SeeedDocument/Ethernet_Shield_V1.0/img/Ethernet_shield1.jpg

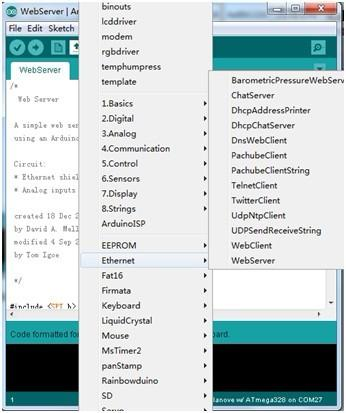
img/Ethernet_shield1.jpg
