SeeedDocument/Ethernet_Shield_V1.0/img/Ethernet_shield3.jpg

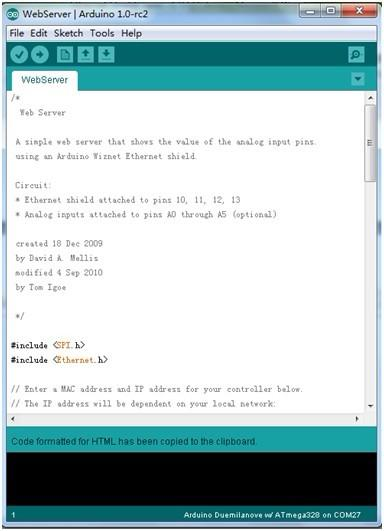
img/Ethernet_shield3.jpg
