SeeedDocument/Ethernet_Shield_V1.0/img/Ethernet_shield_hard.jpg

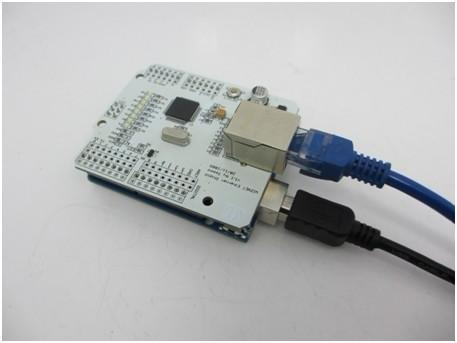
img/Ethernet_shield_hard.jpg
