SeeedDocument/Ethernet_Shield_V1.0/img/Ethernet_Shield_Pic.jpg

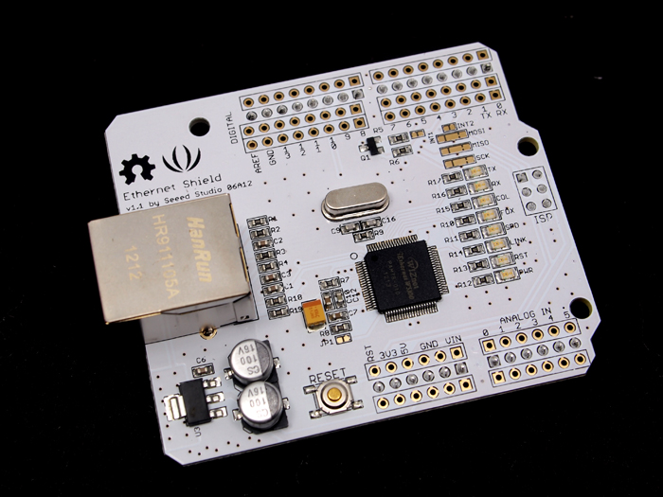
img/Ethernet_Shield_Pic.jpg
