SeeedDocument/Ethernet_Shield_V1.0/res/W5100_ethernet_shield SCH.pdf

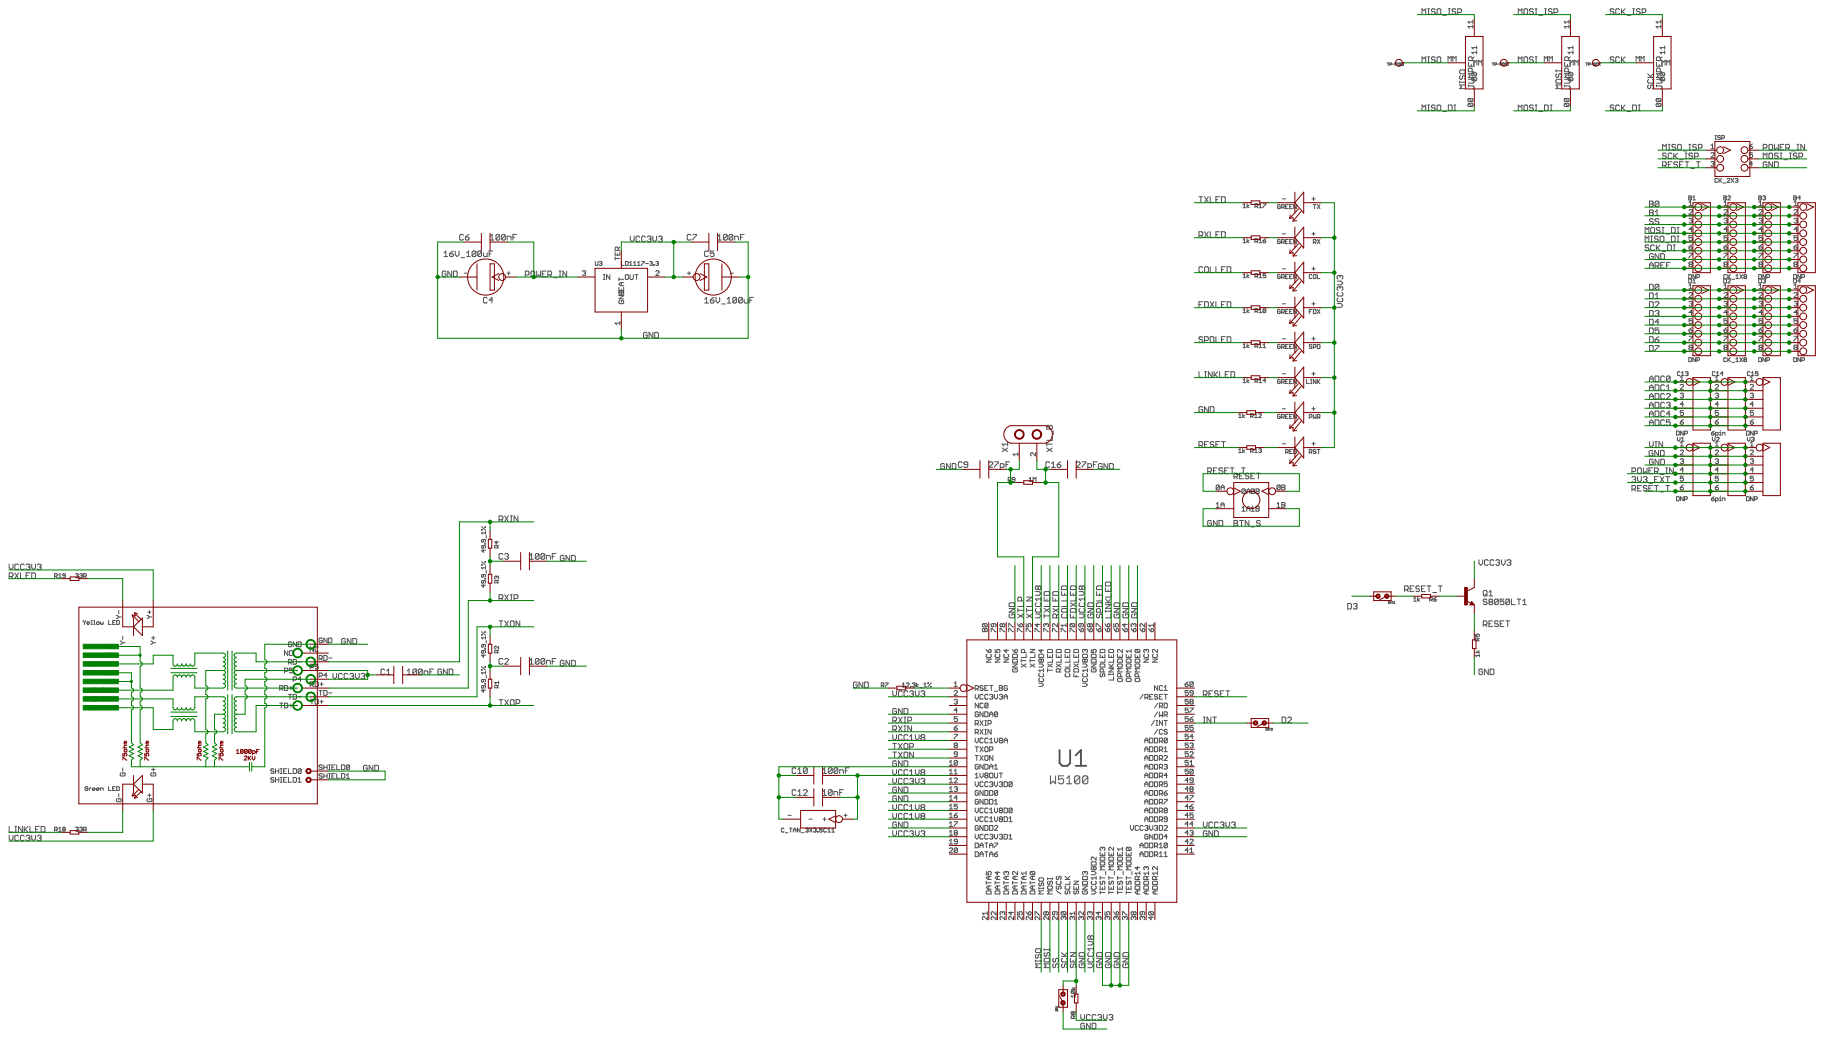
[picture p5: page 1]
