SeeedDocument/Ethernet_Shield_V1.0/res/W5100_ethernet_shield.pdf

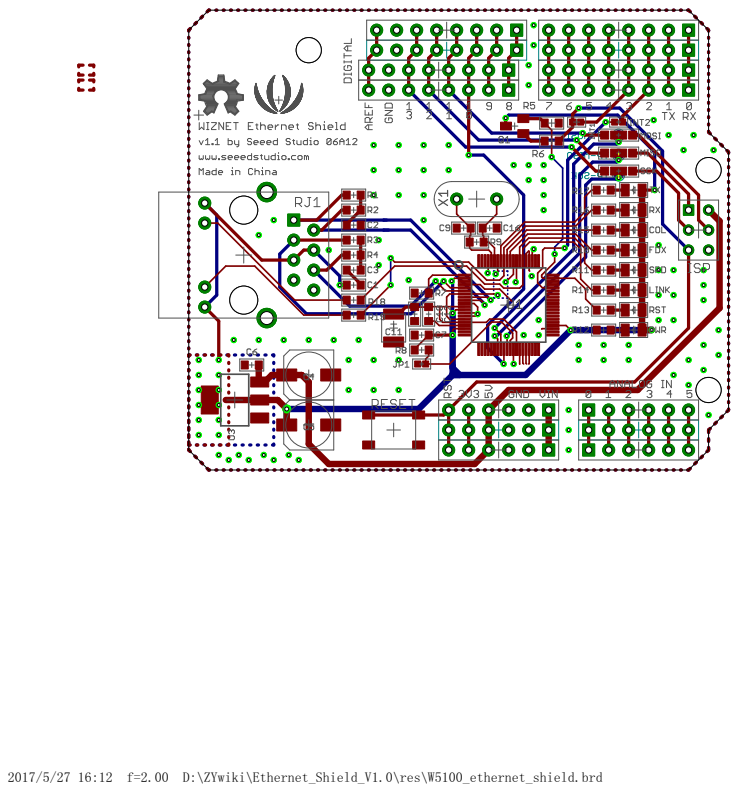
[picture p6: page 1]
