SeeedDocument/Ethernet_Shield_V1.0/res/W5100_ethernet_shield.brd

## EAGLE design res/W5100_ethernet_shield.brd (2017-05-27)

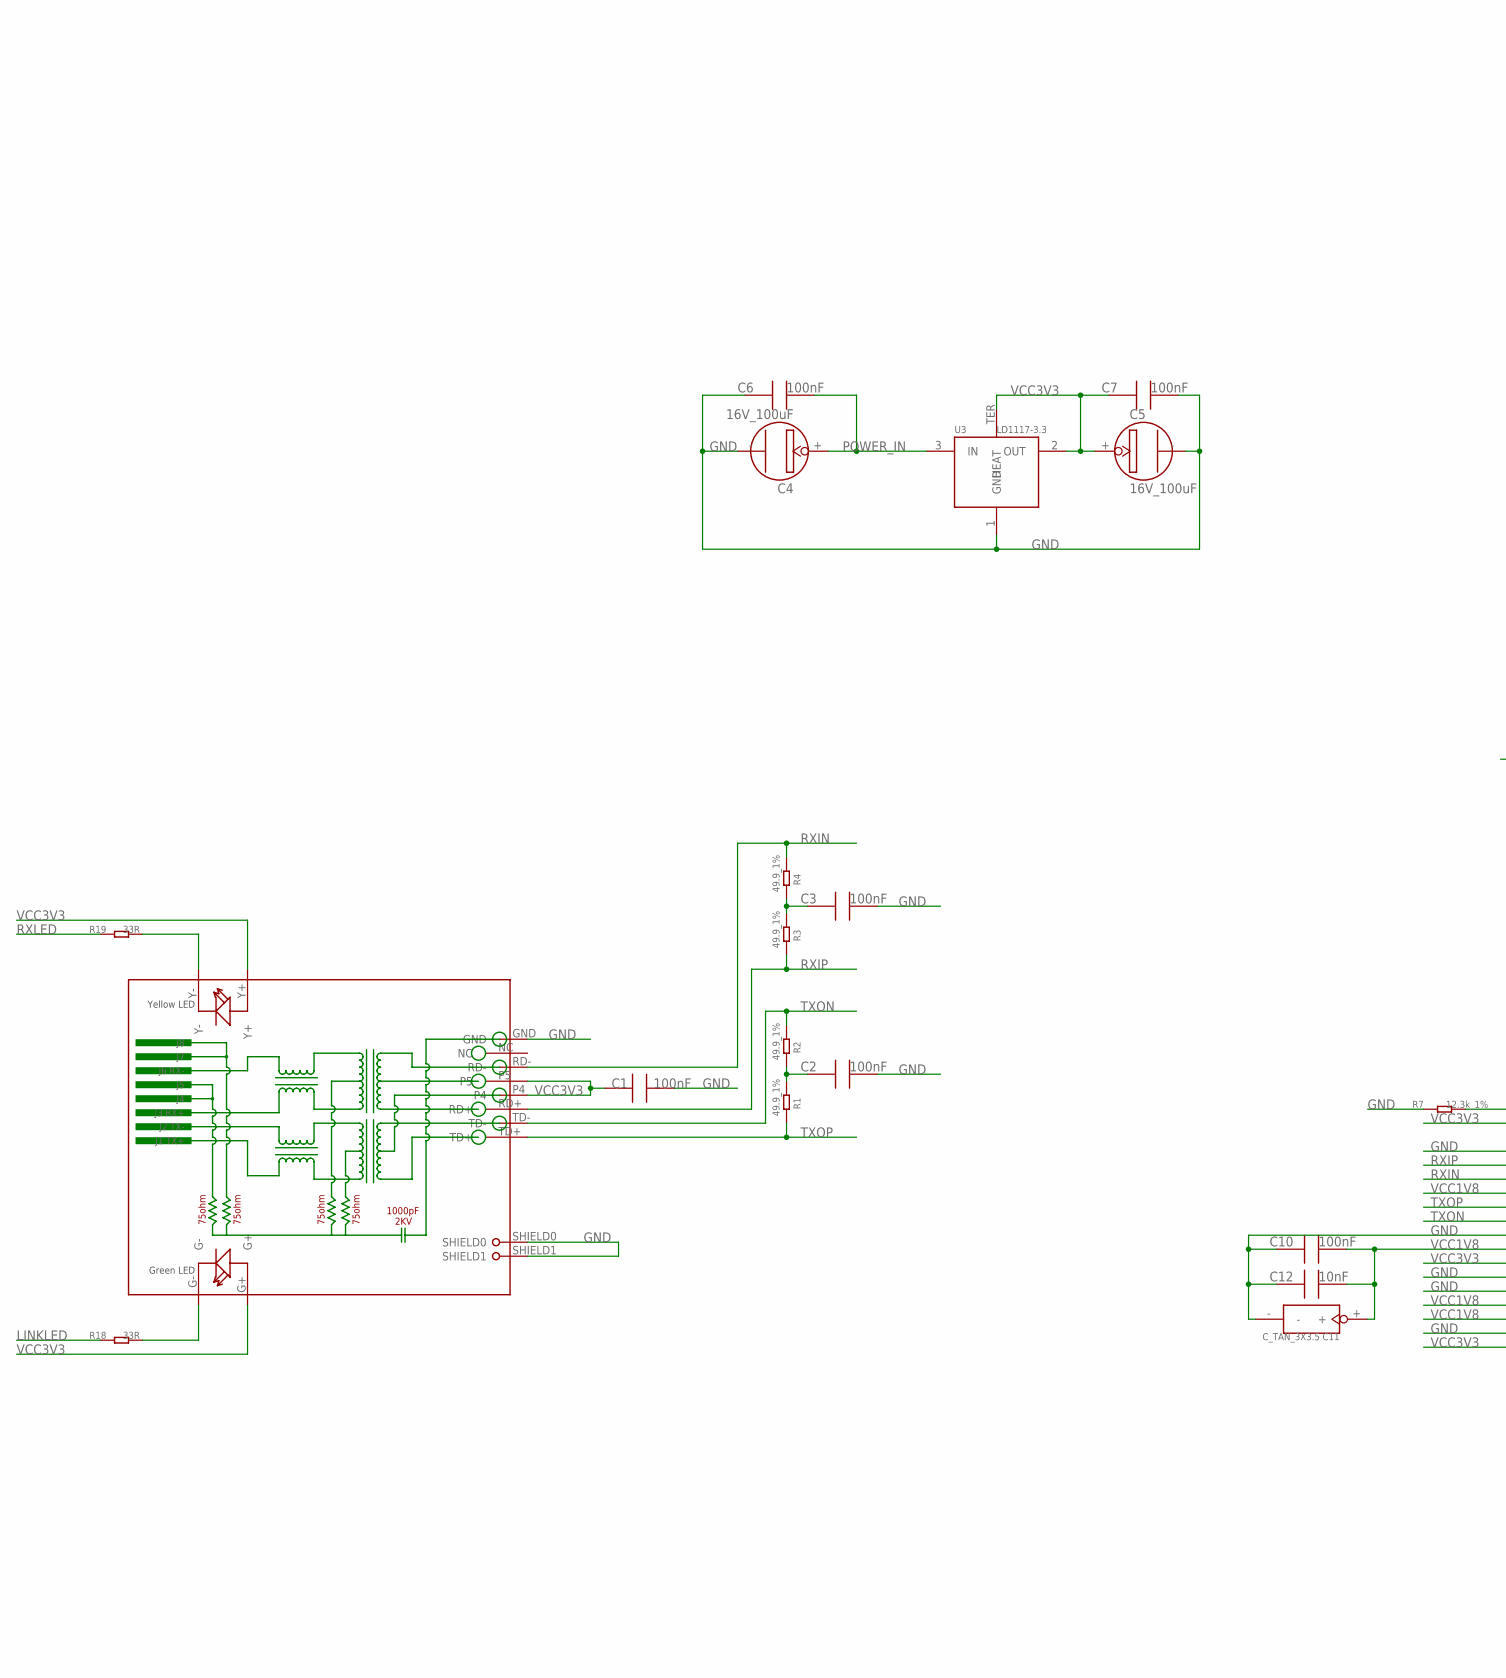
[picture p7: schematic W5100_ethernet_shield.sch, part in row 1, column 1]

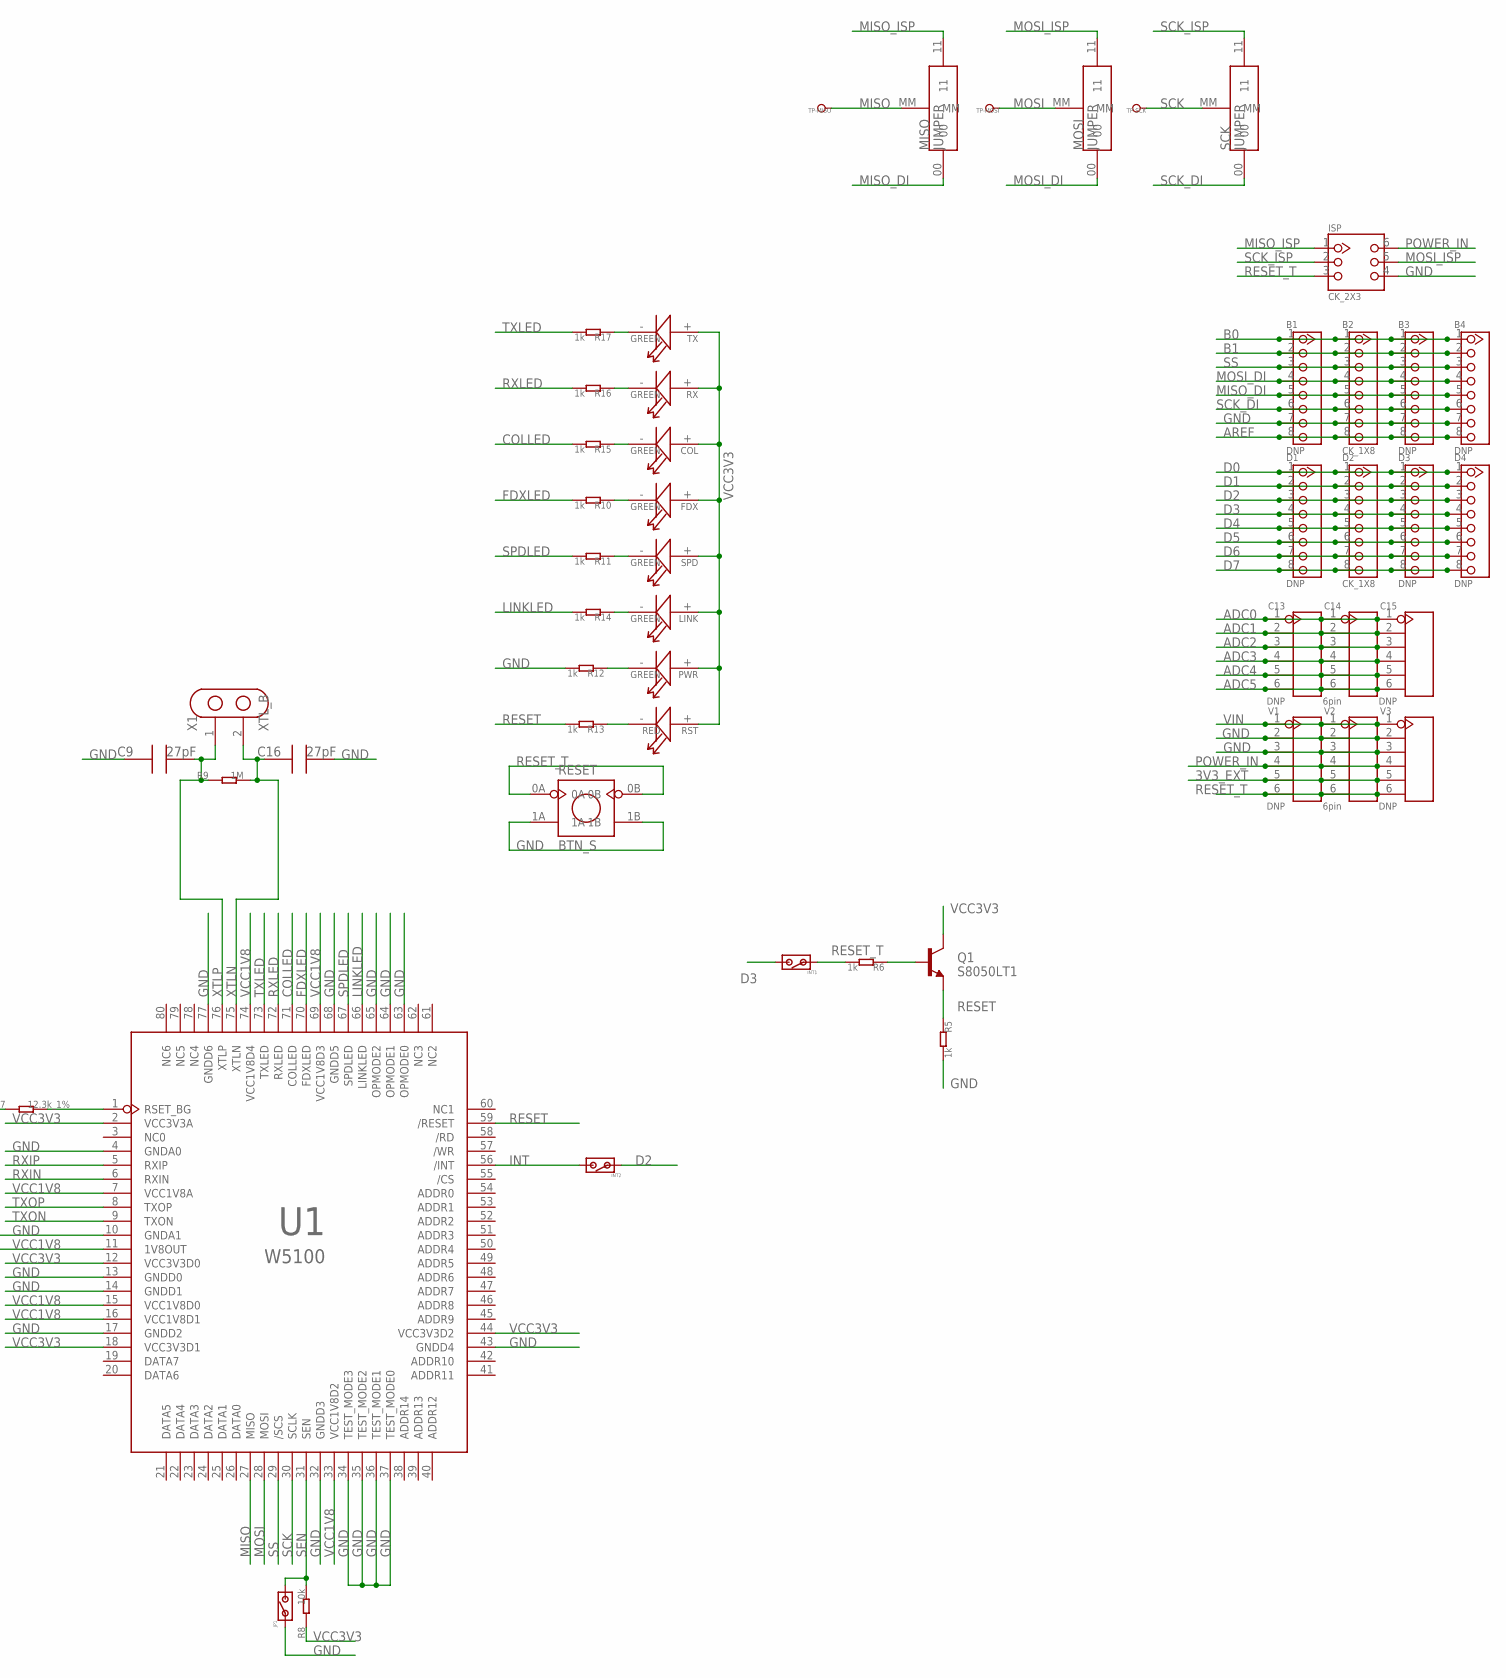
[picture p8: schematic W5100_ethernet_shield.sch, part in row 1, column 2]

Parts:
B1, B3, B4: DNP; CK_1X8
B2: CK_1X8
C1, C2, C3, C6, C7, C10: 100nF; 0603
C4, C5: 16V_100uF; SANYO-OSCON_SMD_C6
C9, C16: 27pF; 0603
C11: C_TAN_3X3.5
C12: 10nF; 0603
C13, C15: DNP; CK_1*6
C14: 6pin; CK_1*6
COL: GREEN; LED0805
D1, D3, D4: DNP; CK_1X8
D2: CK_1X8
FDX: GREEN; LED0805
INT1, INT2: DNP; JP_SW
ISP: CK_2X3; CK_2X3_THIN
JP1: DNP; JP_SW
LINK: GREEN; LED0805
MISO: JUMPER
MOSI: JUMPER
PWR: GREEN; LED0805
Q1: S8050LT1; SOT23
R1, R2, R3, R4: 49.9_1%; 0603
R5, R6, R10, R11, R12, R13, R14, R15, R16, R17: 1k; 0603
R7: 12.3k_1%; 0603
R8: 10k; 0603
R9: 1M; 0603
R18, R19: 33R; 0603
RESET: BTN_S
RJ1: HR911105A
RST: RED; LED0805
RX: GREEN; LED0805
SCK: JUMPER
SPD: GREEN; LED0805
TP-MISO: DNP; TP_45X45
TP-MOSI: DNP; TP_45X45
TP-SCK: DNP; TP_45X45
TX: GREEN; LED0805
U1: W5100; SQFP80
U3: LD1117-3.3; SOT223
V1, V3: DNP; CK_1*6
V2: 6pin; CK_1*6
X1: XTL_B

Connections:
3V3_EXT: V1.5, V2.5, V3.5
ADC0: C13.1, C14.1, C15.1
ADC1: C13.2, C14.2, C15.2
ADC2: C13.3, C14.3, C15.3
ADC3: C13.4, C14.4, C15.4
ADC4: C13.5, C14.5, C15.5
ADC5: C13.6, C14.6, C15.6
AREF: B1.8, B2.8, B3.8, B4.8
B0: B1.1, B2.1, B3.1, B4.1
B1: B1.2, B2.2, B3.2, B4.2
COLLED: R15.2, U1.71 (COLLED)
D0: D1.1, D2.1, D3.1, D4.1
D1: D1.2, D2.2, D3.2, D4.2
D2: D1.3, D2.3, D3.3, D4.3, INT2.1
D3: D1.4, D2.4, D3.4, D4.4, INT1.2
D4: D1.5, D2.5, D3.5, D4.5
D5: D1.6, D2.6, D3.6, D4.6
D6: D1.7, D2.7, D3.7, D4.7
D7: D1.8, D2.8, D3.8, D4.8
FDXLED: R10.2, U1.70 (FDXLED)
GND: B1.7, B2.7, B3.7, B4.7, C1.2, C2.2, C3.2, C4.-, C5.-, C6.1, C7.2, C9.1, C10.1, C11.-, C12.1, C16.2, ISP.4, JP1.1, R5.2, R7.1, R12.2, RESET.1A, RESET.1B, RJ1.GND, RJ1.SHIELD0, RJ1.SHIELD1, U1.4 (GNDA0), U1.10 (GNDA1), U1.13 (GNDD0), U1.14 (GNDD1), U1.17 (GNDD2), U1.32 (GNDD3), U1.34 (TEST_MODE3), U1.35 (TEST_MODE2), U1.36 (TEST_MODE1), U1.37 (TEST_MODE0), U1.43 (GNDD4), U1.63 (OPMODE0), U1.64 (OPMODE1), U1.65 (OPMODE2), U1.68 (GNDD5), U1.77 (GNDD6), U3.1 (GND), V1.2, V1.3, V2.2, V2.3, V3.2, V3.3
INT: INT2.2, U1.56 (/INT)
LINKLED: R14.2, R18.1, U1.66 (LINKLED)
MISO: MISO.MM, TP-MISO.T, U1.27 (MISO)
MISO_DI: B1.5, B2.5, B3.5, B4.5, MISO.00
MISO_ISP: ISP.1, MISO.11
MOSI: MOSI.MM, TP-MOSI.T, U1.28 (MOSI)
MOSI_DI: B1.4, B2.4, B3.4, B4.4, MOSI.00
MOSI_ISP: ISP.5, MOSI.11
unnamed: C2.1, R1.1, R2.2
unnamed: R19.2, RJ1.Y-
unnamed: C3.1, R3.1, R4.2
unnamed: R18.2, RJ1.G-
unnamed: PWR.-, R12.1
unnamed: R13.1, RST.-
unnamed: FDX.-, R10.1
unnamed: Q1.1 (B), R6.1
unnamed: R11.1, SPD.-
unnamed: LINK.-, R14.1
unnamed: COL.-, R15.1
unnamed: R16.1, RX.-
unnamed: R7.2, U1.1 (RSET_BG)
unnamed: R17.1, TX.-
POWER_IN: C4.+, C6.2, ISP.6, U3.3 (IN), V1.4, V2.4, V3.4
RESET: Q1.2 (E), R5.1, R13.2, U1.59 (/RESET)
RESET_T: INT1.1, ISP.3, R6.2, RESET.0A, RESET.0B, V1.6, V2.6, V3.6
RXIN: R4.1, RJ1.RD-, U1.6 (RXIN)
RXIP: R3.2, RJ1.RD+, U1.5 (RXIP)
RXLED: R16.2, R19.1, U1.72 (RXLED)
SCK: SCK.MM, TP-SCK.T, U1.30 (SCLK)
SCK_DI: B1.6, B2.6, B3.6, B4.6, SCK.00
SCK_ISP: ISP.2, SCK.11
SEN: JP1.2, R8.2, U1.31 (SEN)
SPDLED: R11.2, U1.67 (SPDLED)
SS: B1.3, B2.3, B3.3, B4.3, U1.29 (/SCS)
TXLED: R17.2, U1.73 (TXLED)
TXON: R2.1, RJ1.TD-, U1.9 (TXON)
TXOP: R1.2, RJ1.TD+, U1.8 (TXOP)
VCC1V8: C10.2, C11.+, C12.2, U1.7 (VCC1V8A), U1.11 (1V8OUT), U1.15 (VCC1V8D0), U1.16 (VCC1V8D1), U1.33 (VCC1V8D2), U1.69 (VCC1V8D3), U1.74 (VCC1V8D4)
VCC3V3: C1.1, C5.+, C7.1, COL.+, FDX.+, LINK.+, PWR.+, Q1.3 (C), R8.1, RJ1.G+, RJ1.P4, RJ1.P5, RJ1.Y+, RST.+, RX.+, SPD.+, TX.+, U1.2 (VCC3V3A), U1.12 (VCC3V3D0), U1.18 (VCC3V3D1), U1.44 (VCC3V3D2), U3.2 (OUT), U3.TER (HEAT)
VIN: V1.1, V2.1, V3.1
XTLN: C16.1, R9.2, U1.75 (XTLN), X1.2
XTLP: C9.2, R9.1, U1.76 (XTLP), X1.1

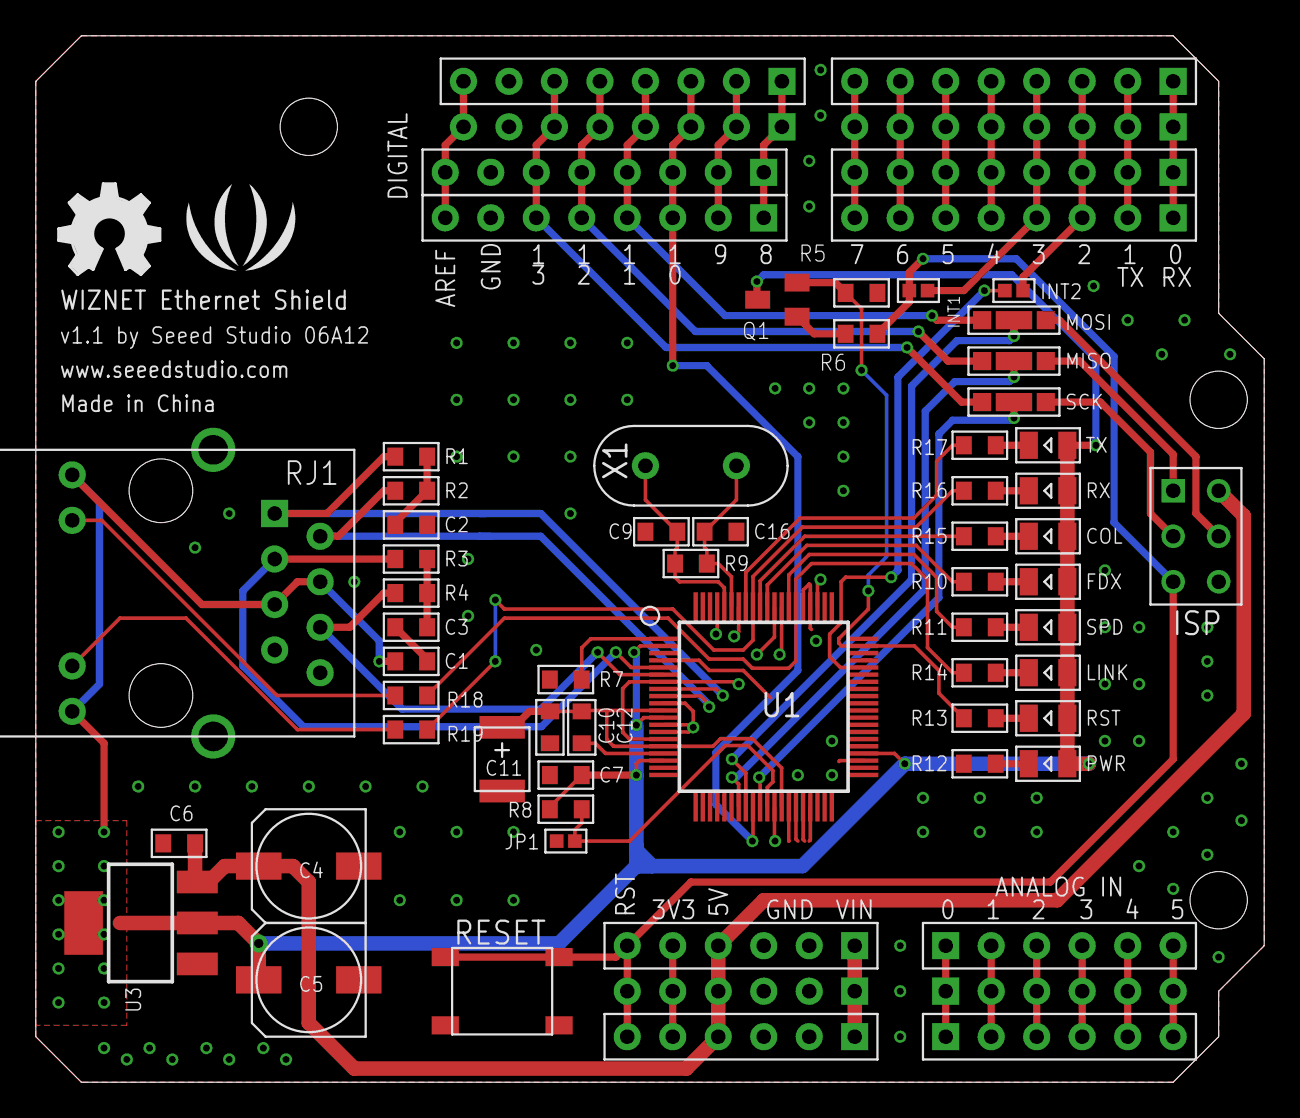
[picture p9: board W5100_ethernet_shield.brd from above]

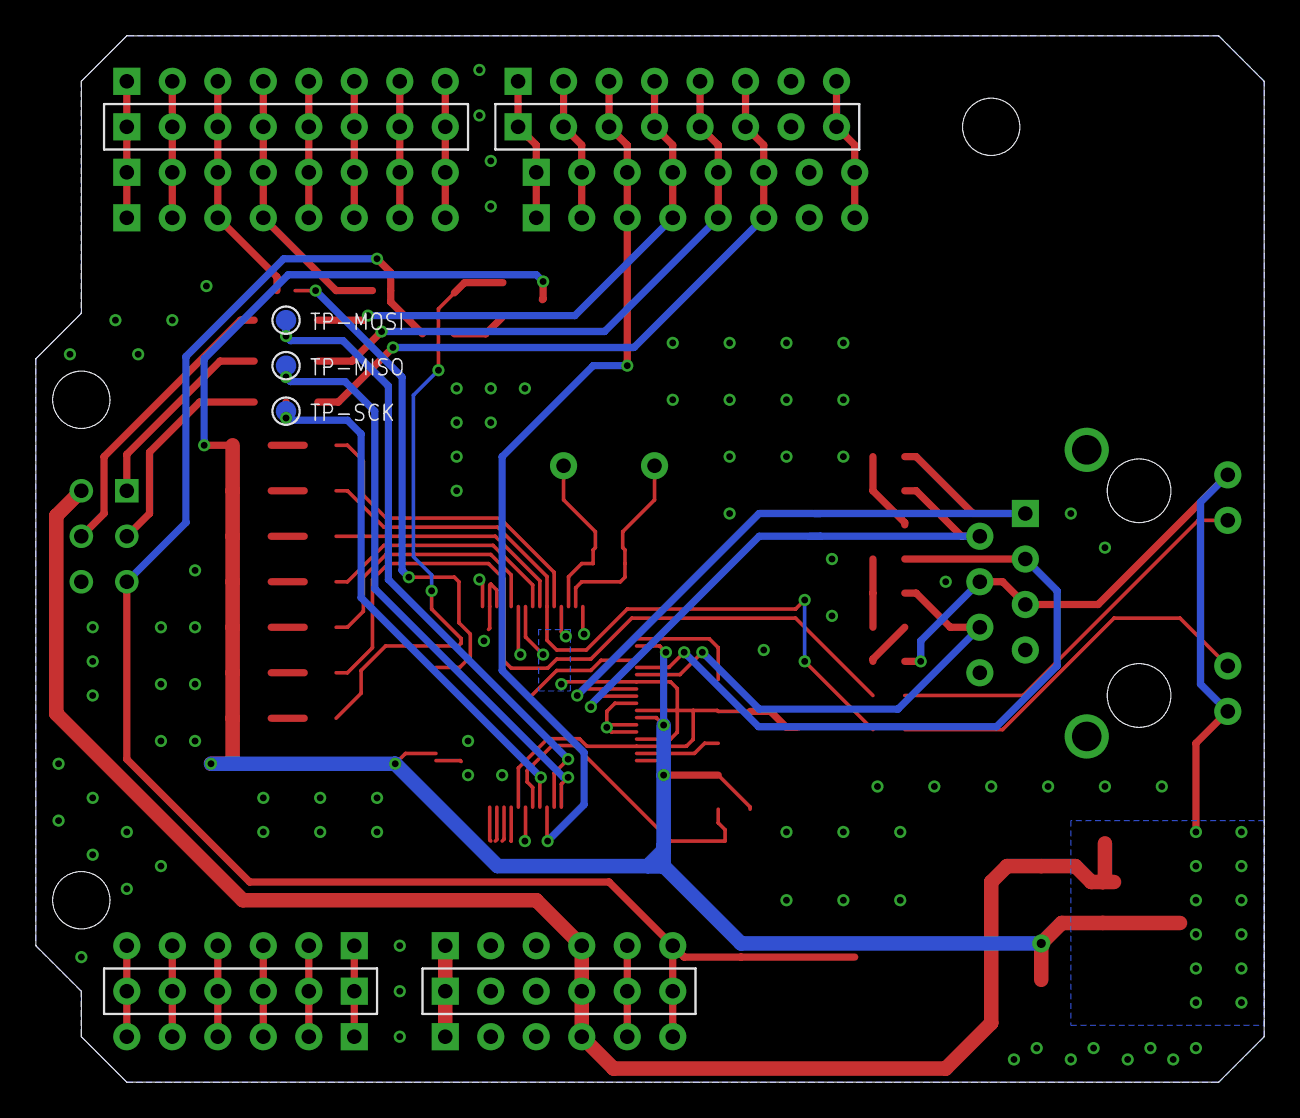
[picture p10: board W5100_ethernet_shield.brd from below]

Board: 2 copper layers, 68.6 x 58.4 mm, 71 parts (7 on the bottom side), 63 nets.

Other parts of the board:
U$1: OSHW_FILLX200_NOTEXT
U$2: LOGO_SILK
